yo3hjv/Arduino_PeP_PWR_SWR_Analog_meter/Schematic_Analog-Arduino-PWR-SWR-meter_2026-02-05.pdf

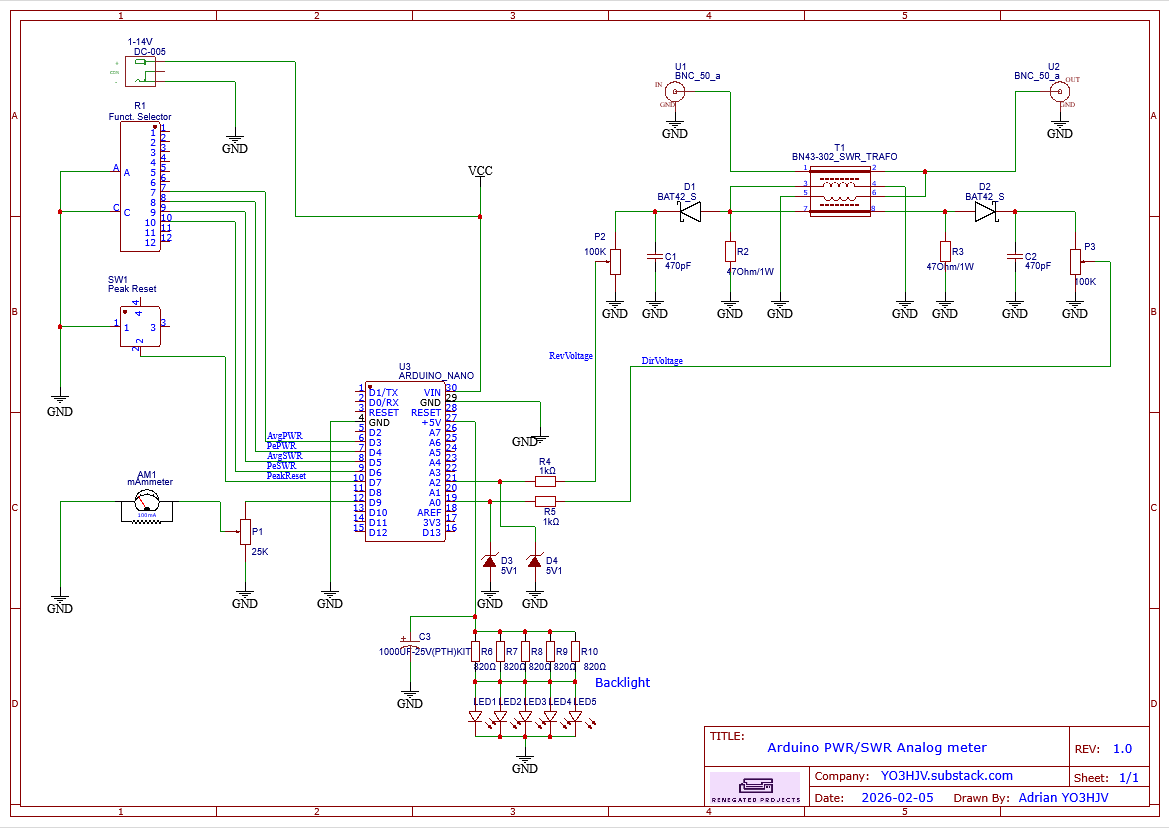
[picture p1: page 1]
