yo3hjv/Arduino_PeP_PWR_SWR_Analog_meter/Schematic_Analog-Arduino-PWR-SWR-meter-1.2_2026-02-06.pdf

1212 1111 1010 9

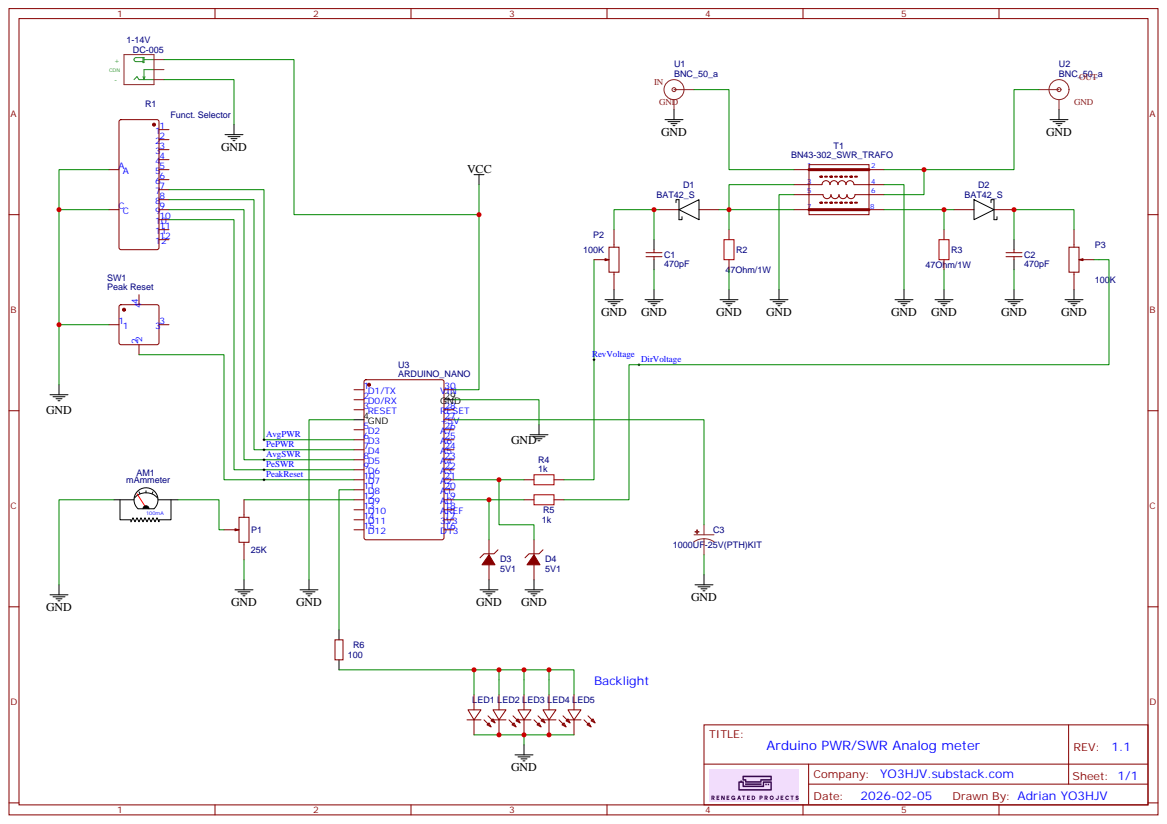
[picture p2: page 1]
